Q-birdman/QX-20/資料/1023/IMG_0112.jpg

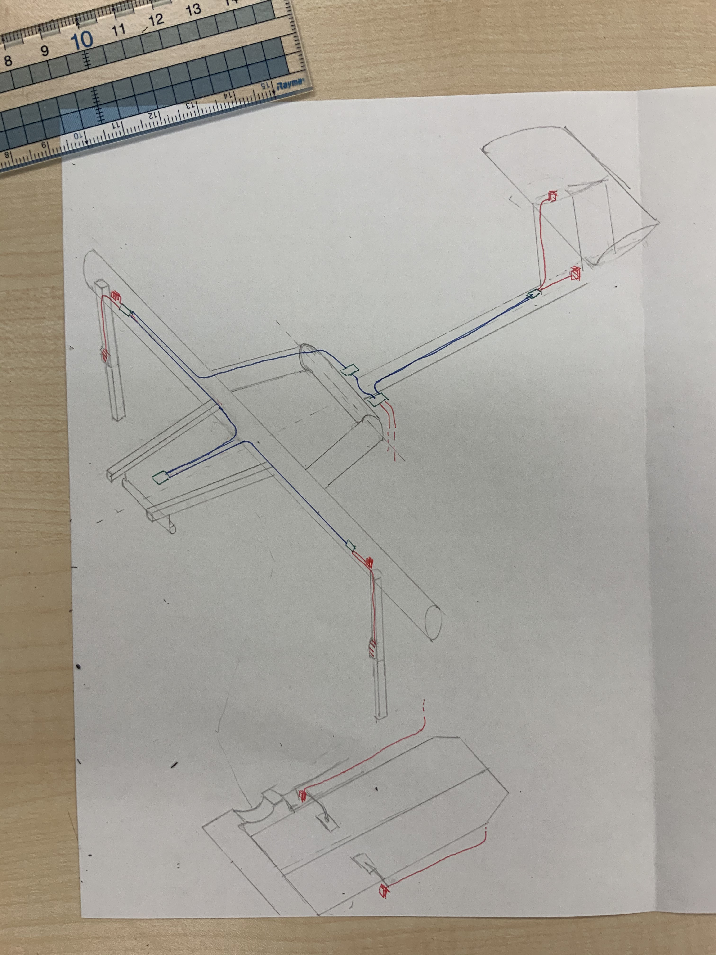
資料/1023/IMG_0112.jpg
