Q-birdman/QX-20/資料/1023/IMG_20191021_135756.jpg

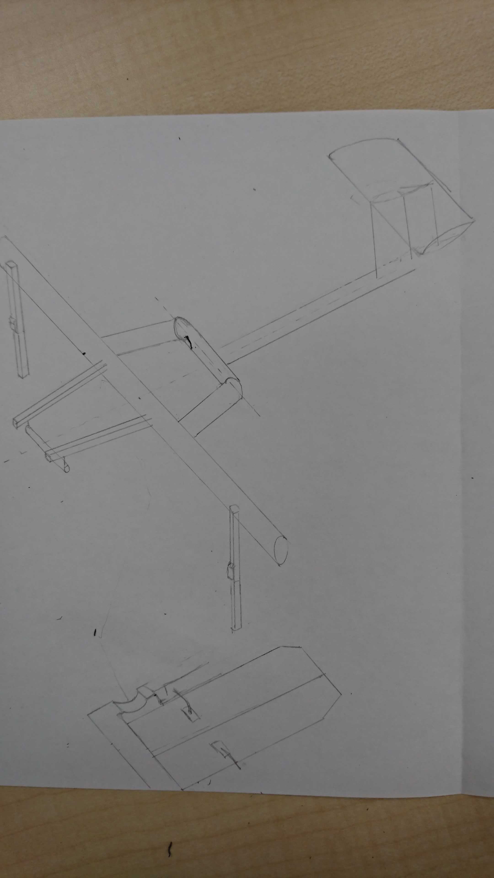
資料/1023/IMG_20191021_135756.jpg
