Q-birdman/QX-20/(list of files, drawings)

Other design files:
Arduino講座/No.4/servo.fzz
