Q-birdman/QX-20/回路/QX20CVT6B8V1/QX20CVT6B8V1.kicad_pcb

## KiCad design 回路/QX20CVT6B8V1/QX20CVT6B8V1.kicad_pcb (2020-10-21)

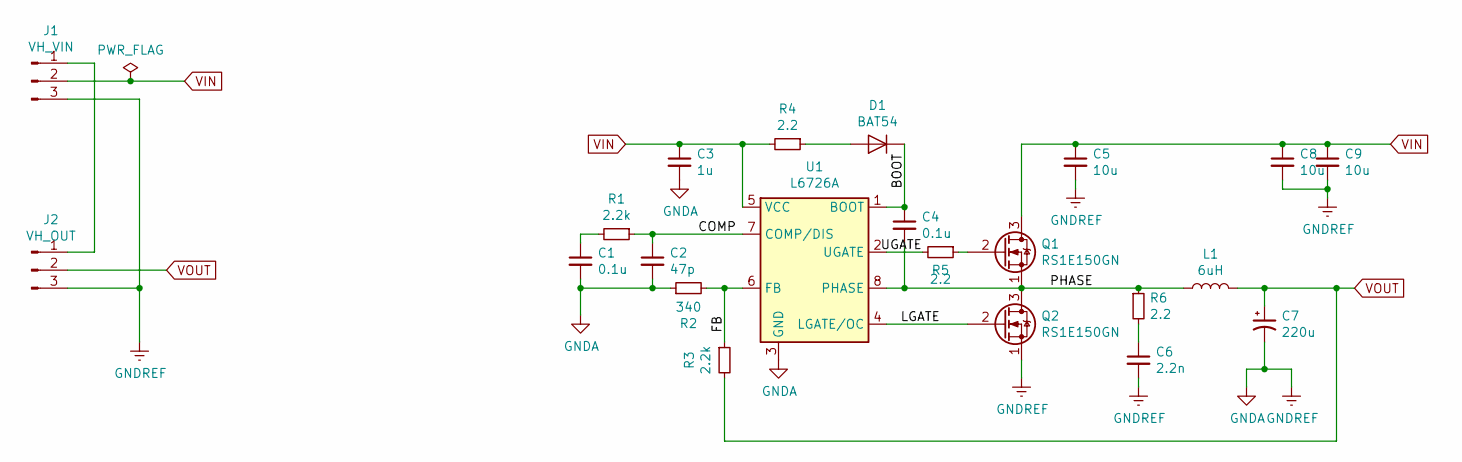
[picture p12: schematic QX20CVT6B8V1.sch]

Parts:
C1, C4: 0.1u; C_1206_3216Metric_Pad1.42x1.75mm_HandSolder
C2: 47p; C_1206_3216Metric_Pad1.42x1.75mm_HandSolder
C3: 1u; C_1206_3216Metric_Pad1.42x1.75mm_HandSolder
C5, C8, C9: 10u; C_1206_3216Metric_Pad1.42x1.75mm_HandSolder
C6: 2.2n; C_1206_3216Metric_Pad1.42x1.75mm_HandSolder
C7: 220u; CP_Radial_D8.0mm_P3.50mm
D1: BAT54; D_SOD-323_HandSoldering
J1: VH_VIN; JST_VH_B3PS-VH_1x03_P3.96mm_Horizontal
J2: VH_OUT; JST_VH_B3P-VH-B_1x03_P3.96mm_Vertical
L1: 6uH; L_Bourns_SRP1250
Q1, Q2: RS1E150GN; VSONP-8-1EP_5x6_P1.27mm
R1, R3: 2.2k; R_1206_3216Metric_Pad1.42x1.75mm_HandSolder
R2: 340; R_1206_3216Metric_Pad1.42x1.75mm_HandSolder
R4, R5, R6: 2.2; R_1206_3216Metric_Pad1.42x1.75mm_HandSolder
U1: L6726A; SOIC-8_3.9x4.9mm_P1.27mm

Connections:
/BOOT: C4.1, D1.1 (K), U1.1 (BOOT)
/COMP: C2.1, R1.1, U1.7 (COMP/DIS)
/FB: R2.2, R3.1, U1.6 (FB)
/LGATE: Q2.2 (G), U1.4 (LGATE/OC)
/PHASE: C4.2, L1.1, Q1.1 (S), Q2.3 (D), R6.1, U1.8 (PHASE)
/UGATE: R5.2, U1.2 (UGATE)
GNDA: C1.2, C2.2, C3.2, C5.2, C6.2, C7.2, C8.2, C9.2, J1.3, J2.3, Q2.1 (S), R2.1, U1.3 (GND)
unnamed: C1.1, R1.2
unnamed: C6.1, R6.2
unnamed: D1.2 (A), R4.1
unnamed: J1.1, J2.1
unnamed: Q1.2 (G), R5.1
VIN: C3.1, C5.1, C8.1, C9.1, J1.2, Q1.3 (D), R4.2, U1.5 (VCC)
VOUT: C7.1, J2.2, L1.2, R3.2

Board: 2 copper layers, 22 parts (0 on the bottom side), 14 nets, no tracks yet.
