Q-birdman/QX-20/回路/QX20CTRLV3/QX20CTRLV3.kicad_pcb

## KiCad design 回路/QX20CTRLV3/QX20CTRLV3.kicad_pcb (2020-03-15)

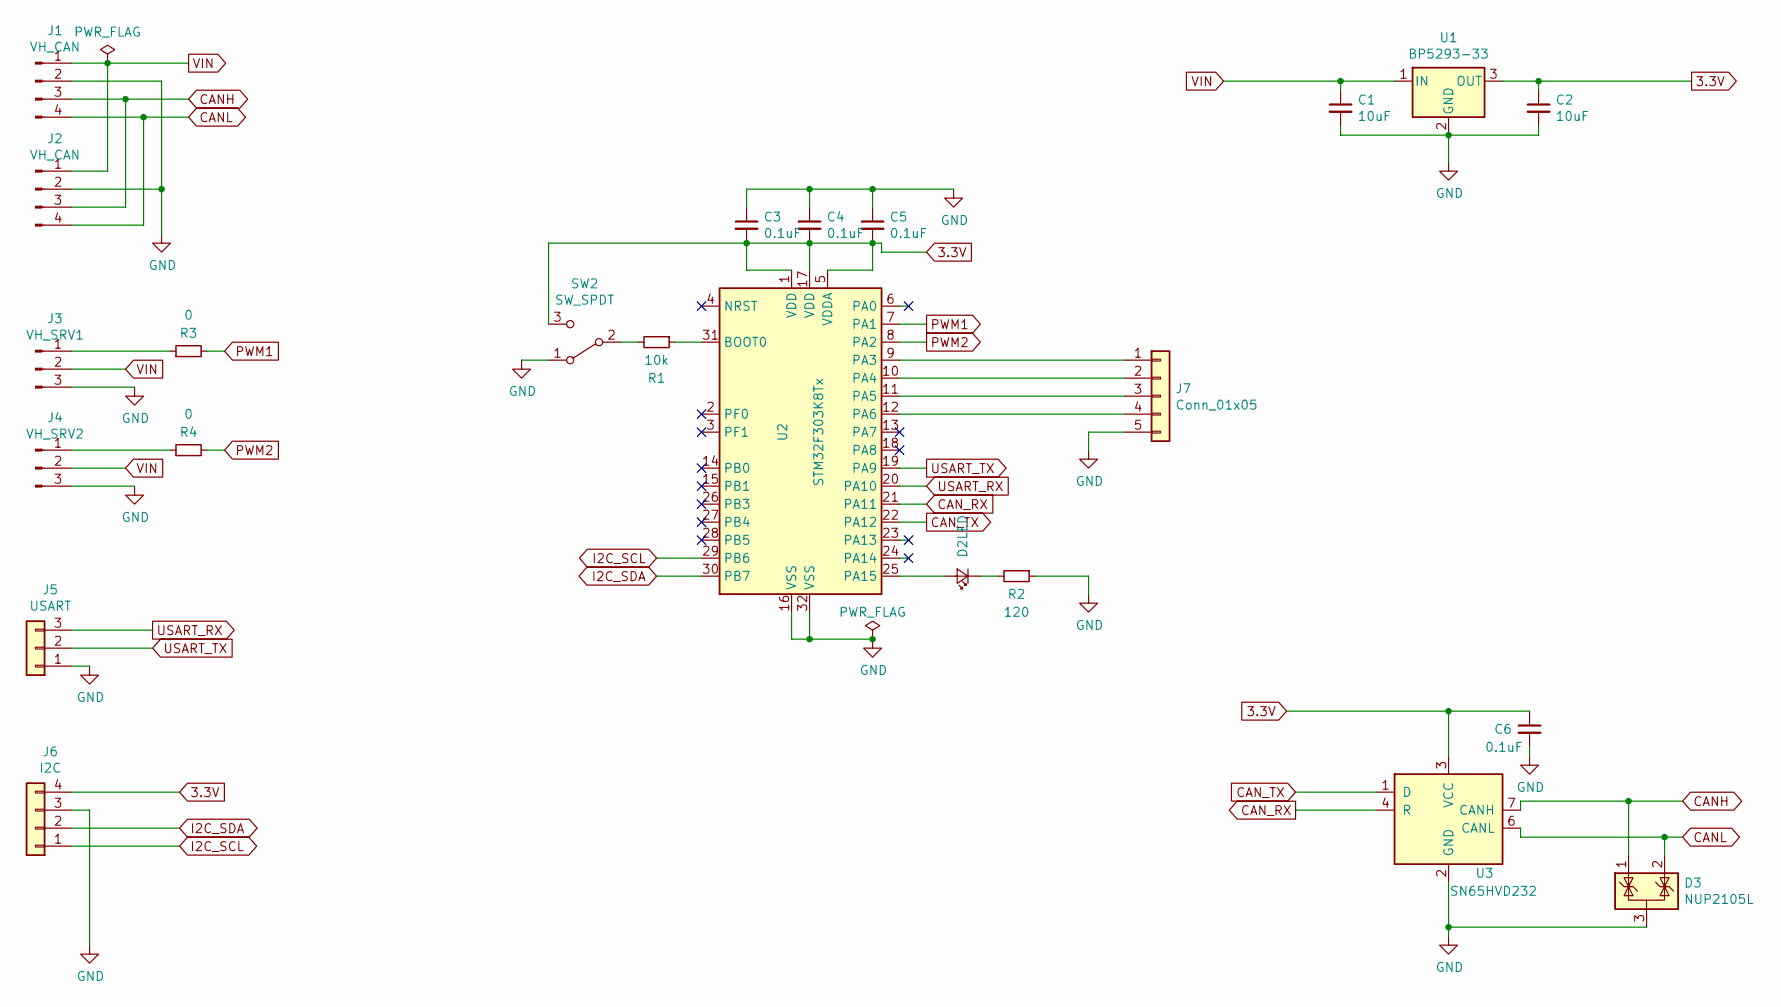
[picture p13: schematic QX20CTRLV3.sch, QX-20 Controller Module]

Parts:
C1, C2: 10uF; C_1206_3216Metric_Pad1.42x1.75mm_HandSolder
C3, C4, C5, C6: 0.1uF; C_1206_3216Metric_Pad1.42x1.75mm_HandSolder
D2: LED; D_1206_3216Metric_Pad1.42x1.75mm_HandSolder
D3: NUP2105L; SOT-23
J1, J2: VH_CAN; JST_VH_B4PS-VH_1x04_P3.96mm_Horizontal
J3: VH_SRV1; JST_VH_B3PS-VH_1x03_P3.96mm_Horizontal
J4: VH_SRV2; JST_VH_B3PS-VH_1x03_P3.96mm_Horizontal
J5: USART; JST_XH_B3B-XH-A_1x03_P2.50mm_Vertical
J6: I2C; JST_XH_B4B-XH-A_1x04_P2.50mm_Vertical
J7: Conn_01x05; JST_XH_B5B-XH-A_1x05_P2.50mm_Vertical
R1: 10k; R_1206_3216Metric_Pad1.42x1.75mm_HandSolder
R2: 120; R_1206_3216Metric_Pad1.42x1.75mm_HandSolder
R3, R4: 0; R_1206_3216Metric_Pad1.42x1.75mm_HandSolder
SW2: SW_SPDT; PinHeader_1x03_P2.54mm_Vertical
U1: BP5293-33; TO-220-3_Vertical
U2: STM32F303K8Tx; LQFP-32_7x7mm_P0.8mm
U3: SN65HVD232; SOIC-8_3.9x4.9mm_P1.27mm

Connections:
3.3V: C2.1, C3.2, C4.2, C5.2, C6.1, J6.4, SW2.3 (C), U1.3 (OUT), U2.1 (VDD), U2.5 (VDDA), U2.17 (VDD), U3.3 (VCC)
CANH: D3.1 (K), J1.3, J2.3, U3.7 (CANH)
CANL: D3.2 (K), J1.4, J2.4, U3.6 (CANL)
CAN_RX: U2.21 (PA11), U3.4 (R)
CAN_TX: U2.22 (PA12), U3.1 (D)
GND: C1.2, C2.2, C3.1, C4.1, C5.1, C6.2, D3.3 (A), J1.2, J2.2, J3.3, J4.3, J5.1, J6.3, J7.5, R2.1, SW2.1 (A), U1.2 (GND), U2.16 (VSS), U2.32 (VSS), U3.2 (GND)
I2C_SCL: J6.1, U2.29 (PB6)
I2C_SDA: J6.2, U2.30 (PB7)
unnamed: D2.1 (K), R2.2
unnamed: D2.2 (A), U2.25 (PA15)
unnamed: J3.1, R3.1
unnamed: J4.1, R4.1
unnamed: J7.1, U2.9 (PA3)
unnamed: J7.2, U2.10 (PA4)
unnamed: J7.3, U2.11 (PA5)
unnamed: J7.4, U2.12 (PA6)
unnamed: R1.1, U2.31 (BOOT0)
unnamed: R1.2, SW2.2 (B)
PWM1: R3.2, U2.7 (PA1)
PWM2: R4.2, U2.8 (PA2)
USART_RX: J5.3, U2.20 (PA10)
USART_TX: J5.2, U2.19 (PA9)
VIN: C1.1, J1.1, J2.1, J3.2, J4.2, U1.1 (IN)

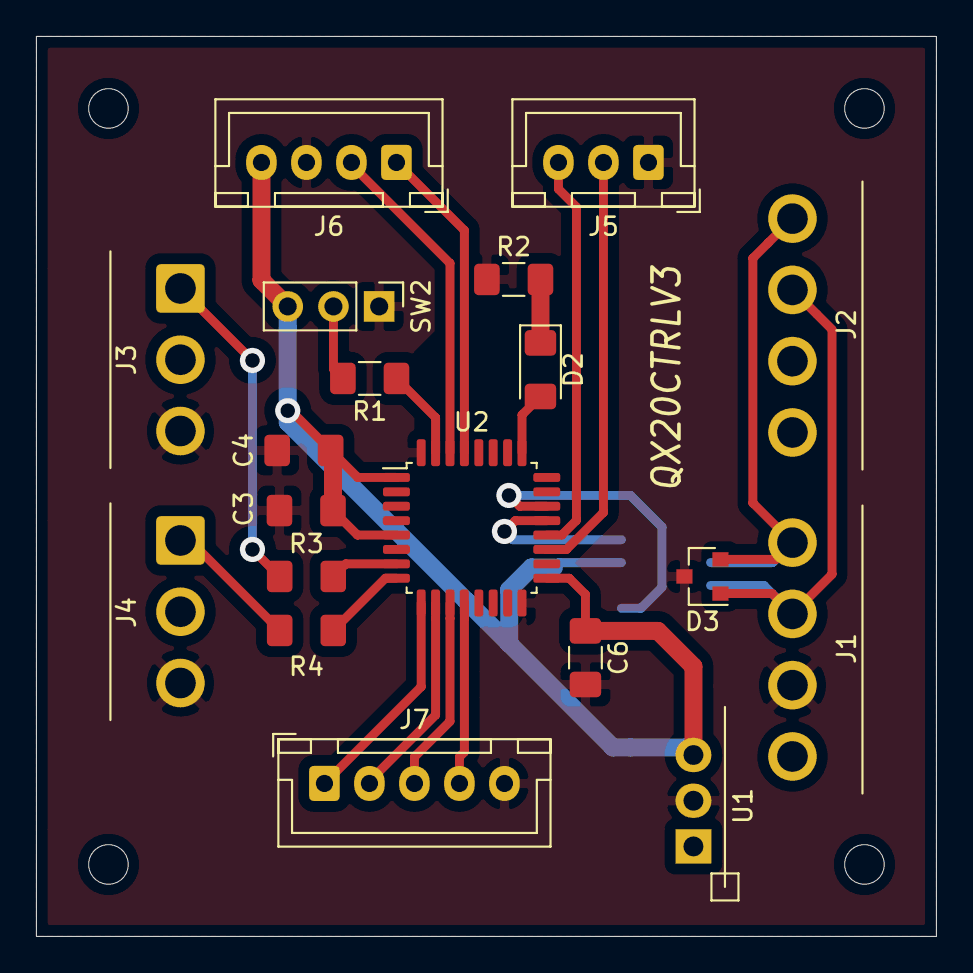
[picture p14: board QX20CTRLV3.kicad_pcb from above]

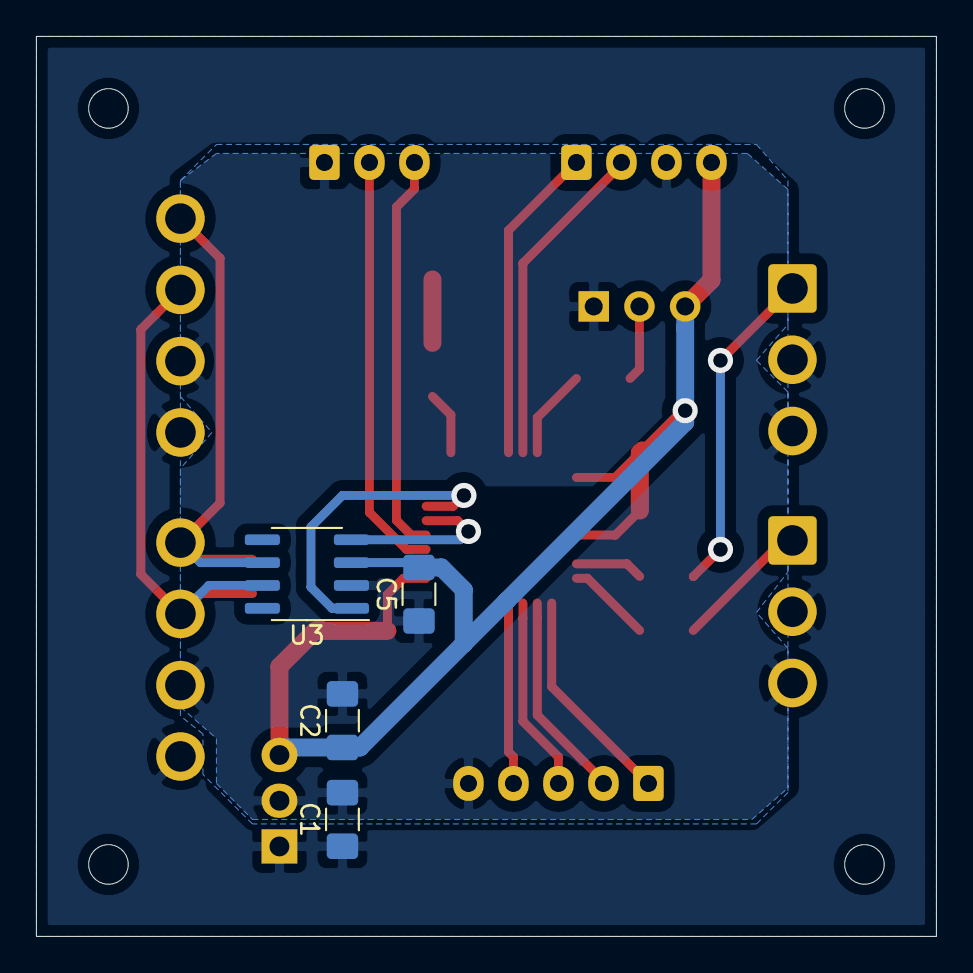
[picture p15: board QX20CTRLV3.kicad_pcb from below]

Board: 2 copper layers, 50.0 x 50.0 mm, 23 parts (4 on the bottom side), 23 nets.
