Q-birdman/QX-20/回路/QX20CTRLV2/QX20CTRLV2.kicad_pcb

## KiCad design 回路/QX20CTRLV2/QX20CTRLV2.kicad_pcb (2020-02-28)

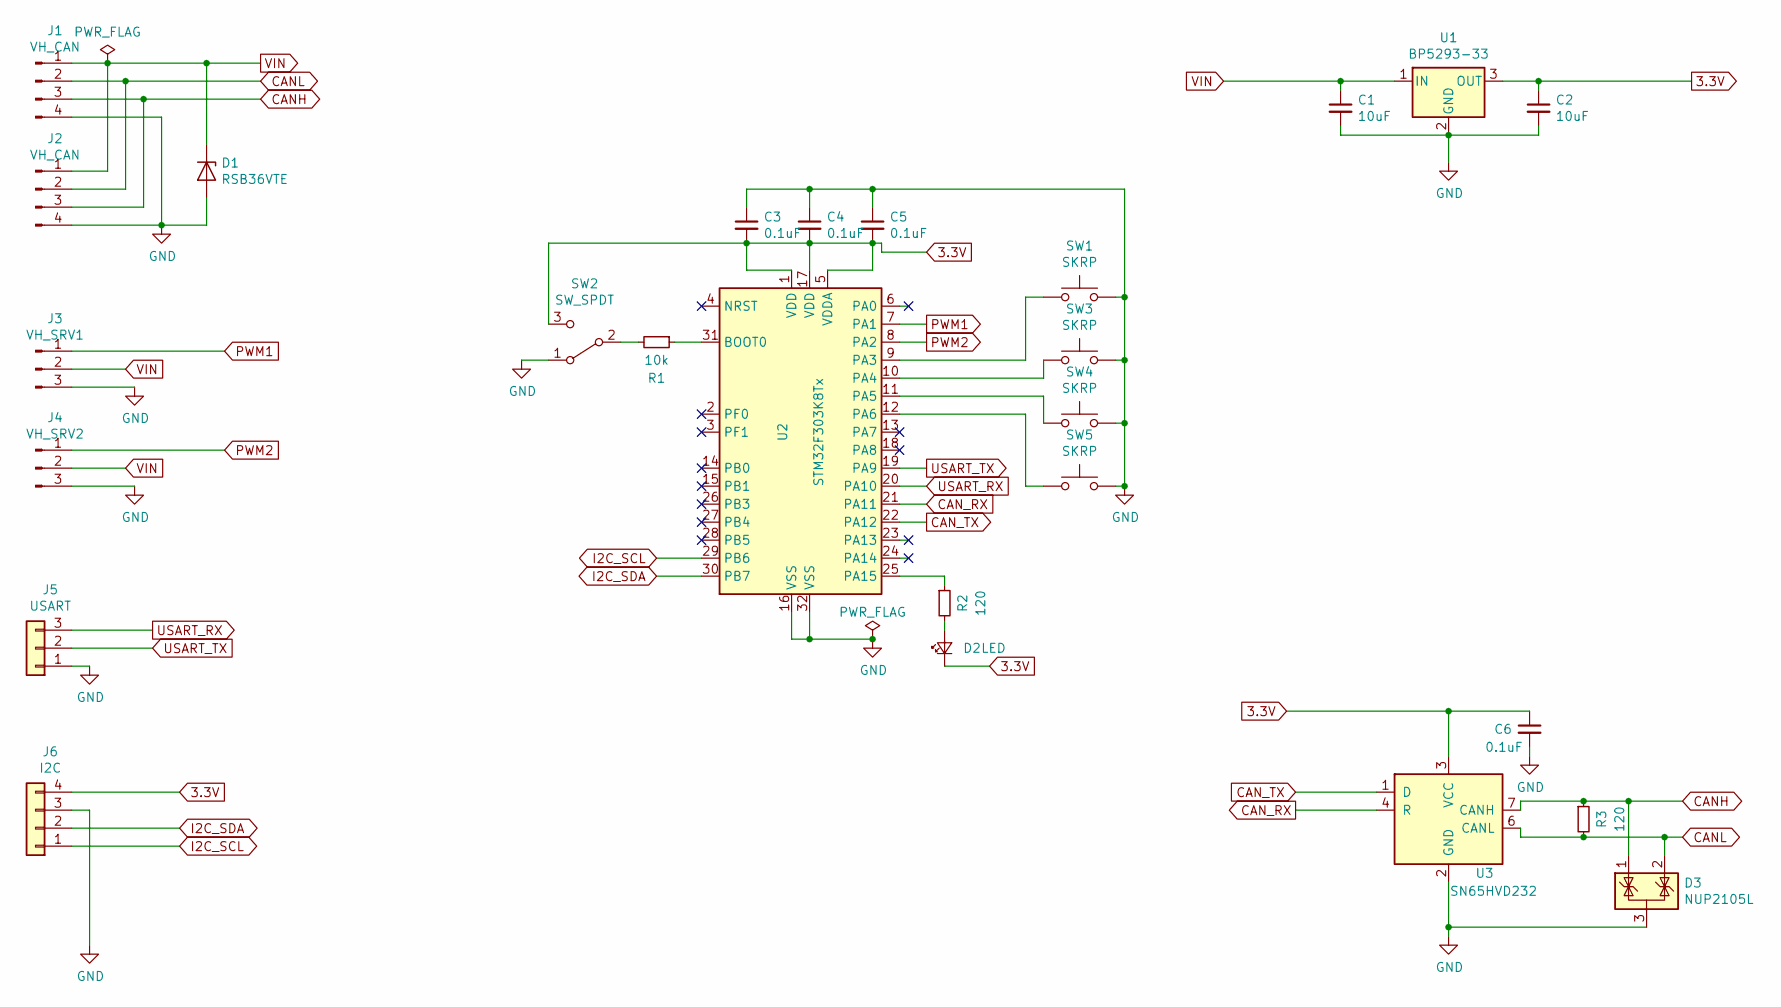
[picture p16: schematic QX20CTRLV2.sch, QX-20 Controller Module]

Parts:
C1, C2: 10uF; C_1206_3216Metric_Pad1.42x1.75mm_HandSolder
C3, C4, C5, C6: 0.1uF; C_1206_3216Metric_Pad1.42x1.75mm_HandSolder
D1: RSB36VTE; D_SOD-323_HandSoldering
D2: LED; D_1206_3216Metric_Pad1.42x1.75mm_HandSolder
D3: NUP2105L; SOT-23
J1, J2: VH_CAN; JST_VH_B4PS-VH_1x04_P3.96mm_Horizontal
J3: VH_SRV1; JST_VH_B3PS-VH_1x03_P3.96mm_Horizontal
J4: VH_SRV2; JST_VH_B3PS-VH_1x03_P3.96mm_Horizontal
J5: USART; PinSocket_1x03_P2.54mm_Vertical
J6: I2C; PinSocket_1x04_P2.54mm_Vertical
R1: 10k; R_1206_3216Metric_Pad1.42x1.75mm_HandSolder
R2, R3: 120; R_1206_3216Metric_Pad1.42x1.75mm_HandSolder
SW1, SW3, SW4, SW5: SKRP; SW_SPST_PTS810
SW2: SW_SPDT; PinHeader_1x03_P2.54mm_Vertical
U1: BP5293-33; TO-220-3_Vertical
U2: STM32F303K8Tx; LQFP-32_7x7mm_P0.8mm
U3: SN65HVD232; SOIC-8_3.9x4.9mm_P1.27mm

Connections:
3.3V: C2.1, C3.2, C4.2, C5.2, C6.1, D2.1 (K), J6.4, SW2.3 (C), U1.3 (OUT), U2.1 (VDD), U2.5 (VDDA), U2.17 (VDD), U3.3 (VCC)
CANH: D3.1 (K), J1.3, J2.3, R3.1, U3.7 (CANH)
CANL: D3.2 (K), J1.2, J2.2, R3.2, U3.6 (CANL)
CAN_RX: U2.21 (PA11), U3.4 (R)
CAN_TX: U2.22 (PA12), U3.1 (D)
GND: C1.2, C2.2, C3.1, C4.1, C5.1, C6.2, D1.2 (A), D3.3 (A), J1.4, J2.4, J3.3, J4.3, J5.1, J6.3, SW1.2, SW2.1 (A), SW3.2, SW4.2, SW5.2, U1.2 (GND), U2.16 (VSS), U2.32 (VSS), U3.2 (GND)
I2C_SCL: J6.1, U2.29 (PB6)
I2C_SDA: J6.2, U2.30 (PB7)
unnamed: D2.2 (A), R2.2
unnamed: R1.1, U2.31 (BOOT0)
unnamed: R1.2, SW2.2 (B)
unnamed: R2.1, U2.25 (PA15)
unnamed: SW1.1, U2.9 (PA3)
unnamed: SW3.1, U2.10 (PA4)
unnamed: SW4.1, U2.11 (PA5)
unnamed: SW5.1, U2.12 (PA6)
PWM1: J3.1, U2.7 (PA1)
PWM2: J4.1, U2.8 (PA2)
USART_RX: J5.3, U2.20 (PA10)
USART_TX: J5.2, U2.19 (PA9)
VIN: C1.1, D1.1 (K), J1.1, J2.1, J3.2, J4.2, U1.1 (IN)

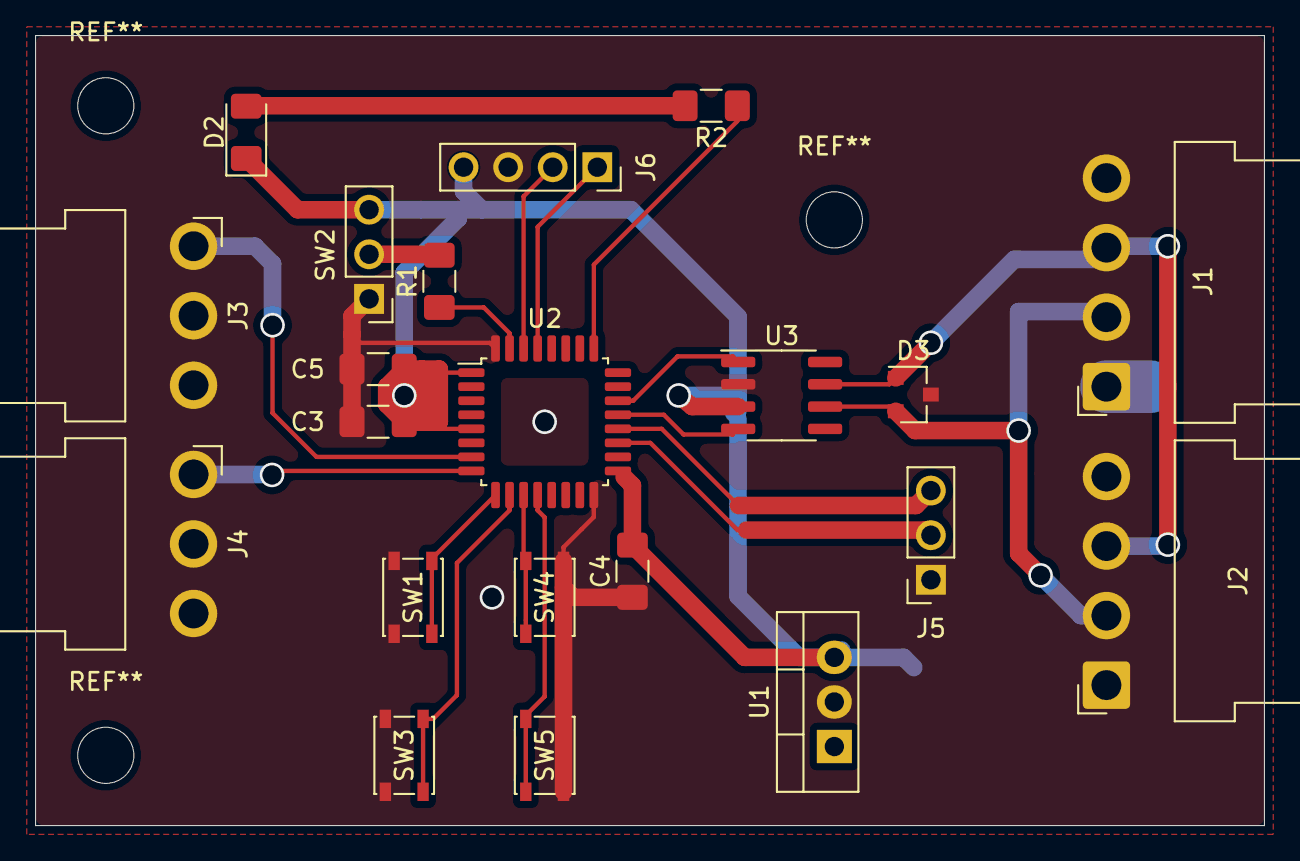
[picture p17: board QX20CTRLV2.kicad_pcb from above]

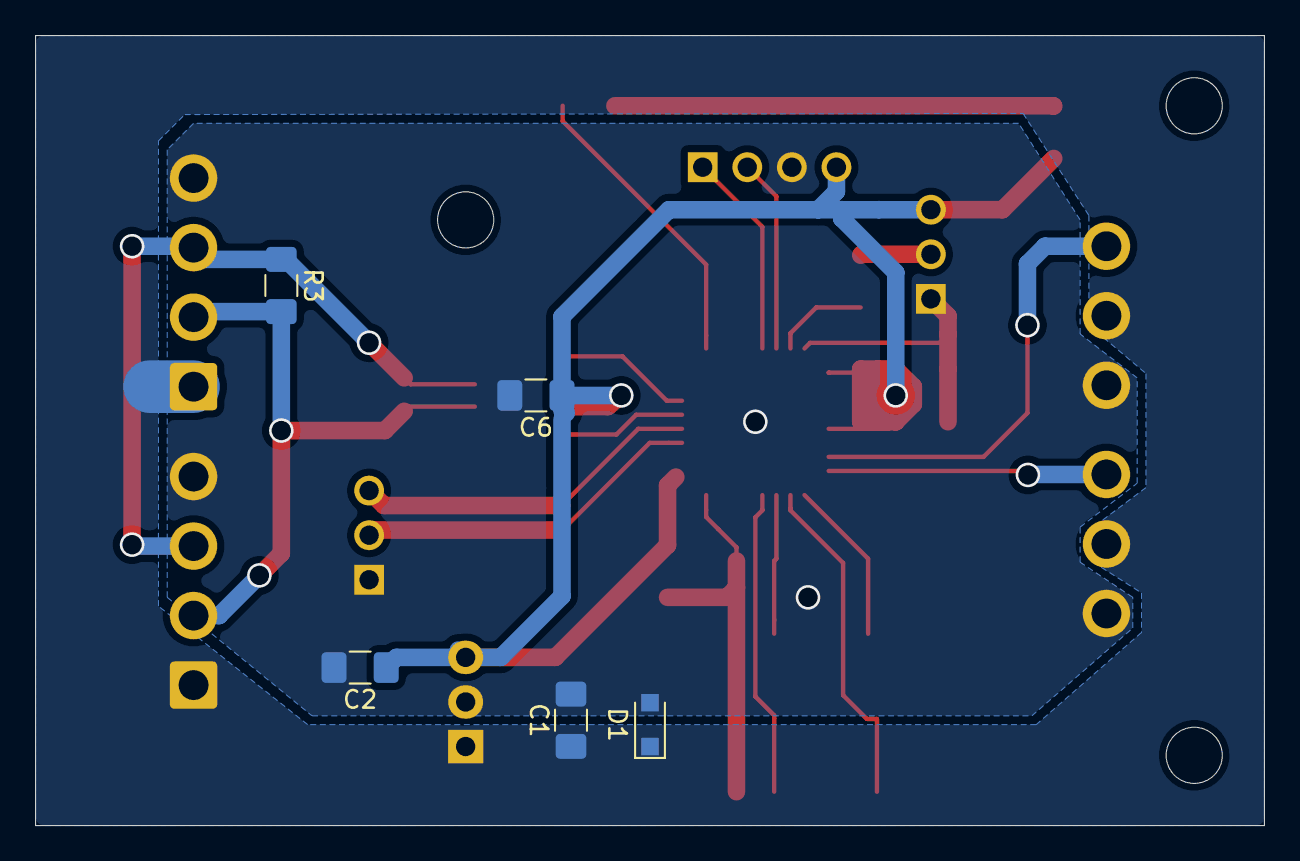
[picture p18: board QX20CTRLV2.kicad_pcb from below]

Board: 2 copper layers, 70.0 x 45.0 mm, 26 parts (5 on the bottom side), 21 nets.
