Q-birdman/QX-20/program/QX20CTRLV3/QX20CTRLV3.ioc

Mcu.UserName=STM32F303K8Tx
PA1.Signal=S_TIM2_CH2
PA10.Signal=USART1_RX
PA11.Signal=CAN_RX
PA12.Signal=CAN_TX
PA15.Signal=GPIO_Output
PA2.Signal=S_TIM2_CH3
PA3.Signal=GPXTI3
PA4.Signal=GPXTI4
PA5.Signal=GPXTI5
PA6.Signal=GPXTI6
PA9.Signal=USART1_TX
