Q-birdman/QX-20/(commit log)

2019-09-11 空のデータ送っちゃった!
2019-09-11 私がQiitaに上げてる講座のプログラムです。気になる方はご確認ください。 また、テストで上げたファイルは削除しました。
2019-09-11 距離センサーと七セグ
    作りました
2019-10-04 gitignore編集
    藤田が試しにやりました。
2019-10-30 電装講座No.4を追加しました。
    [servo.fzz]
2019-10-30 no.4のメインプログラムです。
2019-11-01 小さめの修正
2019-11-08 可変抵抗器で出力できるようにしたつもり。
2019-11-08 ちゃんと出るように改善しました。
2019-11-08 光度が数値で出るように
2019-11-09 今できてるもの
    [QX20CTRLV0.kicad_pcb, QX20CTRLV0.sch]
2019-11-11 フォルダ整理
    「プログラム」等日本語だとバグるので、名前変更。
2019-11-14 QX20CTRLPOCV0
    QX20 CTRL POC用
    角度出し時使用プログラム
    VSCode上環境での使用前提
2019-11-20 ﾊﾝﾁｮｳのおもちゃ。
2019-11-28 飛行試験時プログラム
2019-12-12 pyデータの作成/video対応
2019-12-22 きちんと動くようにしました。
2019-12-23 QX20CTRLV1 回路図
    QX20 コントローラー
    + STM32F303K8T6
    + サーボ 2ch
    + I2C, USART, SWD(debug)
    + LED*1
    + 活線挿抜対応
    [QX20CTRLV1.kicad_pcb, QX20CTRLV1.sch]
2019-12-26 for jetson
2019-12-26 jetson用
2019-12-28 名前変更、待機時間
2020-02-18 QX20CTRLV2
    QX20コントローラーV2 NC基板用
    回路図、実装図、ガーバーデータまで。
    [QX20CTRLV1-B_Cu.gbr, QX20CTRLV1-B_Mask.gbr, QX20CTRLV1-B_Paste.gbr, QX20CTRLV1-B_SilkS.gbr, QX20CTRLV1-Edge_Cuts.gbr, QX20CTRLV1-F_Cu.gbr, QX20CTRLV1-F_Mask.gbr, QX20CTRLV1-F_Paste.gbr]
2020-02-28 QX20CTRLV2 ガーバーデータ
    [QX20CTRLV2-B_Cu.gbr, QX20CTRLV2-B_Mask.gbr, QX20CTRLV2-Edge_Cuts.gbr, QX20CTRLV2-F_Cu.gbr, QX20CTRLV2-F_Mask.gbr, QX20CTRLV2-NPTH-drl_map.gbr, QX20CTRLV2-NPTH.drl, QX20CTRLV2-PTH-drl_map.gbr]
2020-03-15 QX20CTRLV3発注仕様
    [QX20CTRLV3-B_Cu.gbr, QX20CTRLV3-B_Mask.gbr, QX20CTRLV3-Edge_Cuts.gbr, QX20CTRLV3-F_Cu.gbr, QX20CTRLV3-F_Mask.gbr, QX20CTRLV3-F_SilkS.gbr, QX20CTRLV3-NPTH.drl, QX20CTRLV3.drl]
2020-04-03 QX20CBT6B8V1 回路図
    [QX20CVT6B8V1.kicad_pcb, QX20CVT6B8V1.sch]
2020-10-21 QX20CTRLV3
    たまっていた分を更新...
    [QX20CVT6B8V1.kicad_pcb, QX20CVT6B8V1.sch]
2020-11-02 QX20CTRLV3 サーボ回転のバグ修正
2020-11-18 QX20CTRLV3 途中
2020-12-11 QX20CTRLV3 途中
    やらんとあかんよ
